mymy49/GM100/Schematics/ES.1/GM100.kicad_pcb

## KiCad design Schematics/ES.1/GM100.kicad_pcb (2026-05-09)

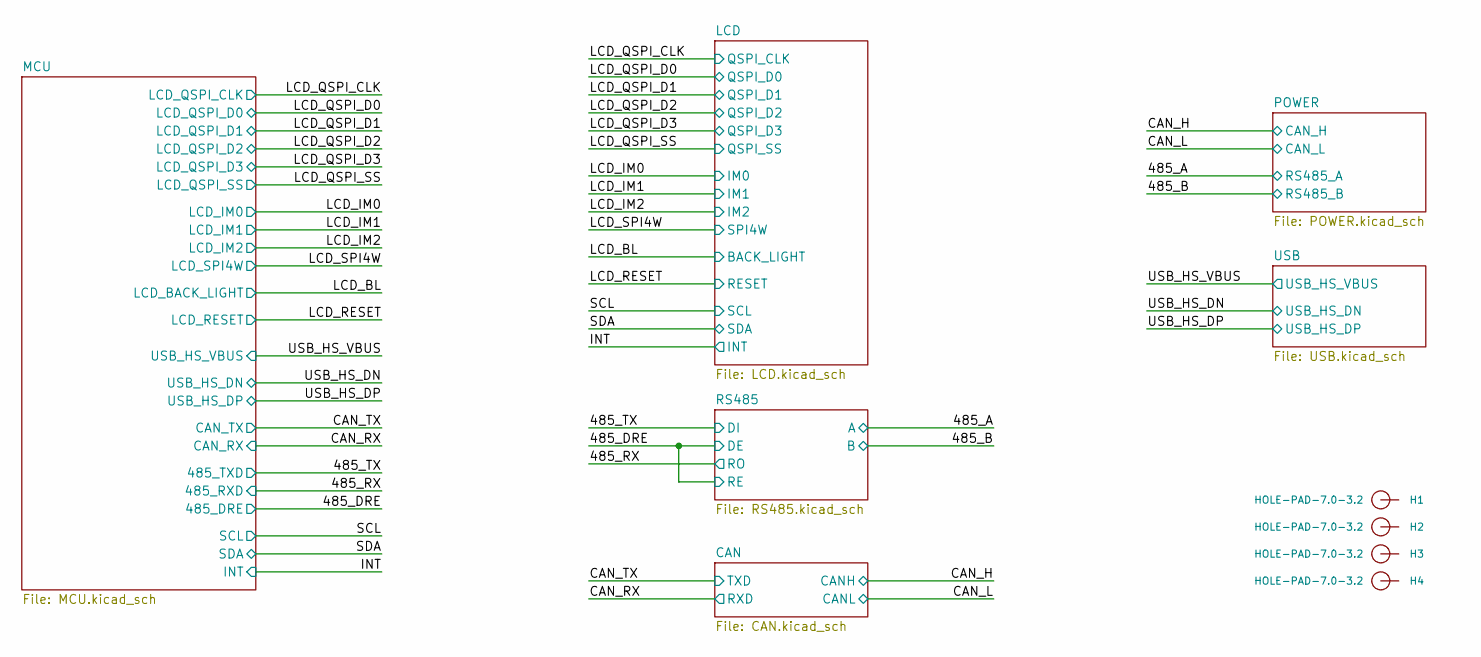
[picture p1: schematic GM100.kicad_sch]

Parts:
H1, H2, H3, H4: HOLE-PAD-7.0-3.2; Hole_7_0_3_2

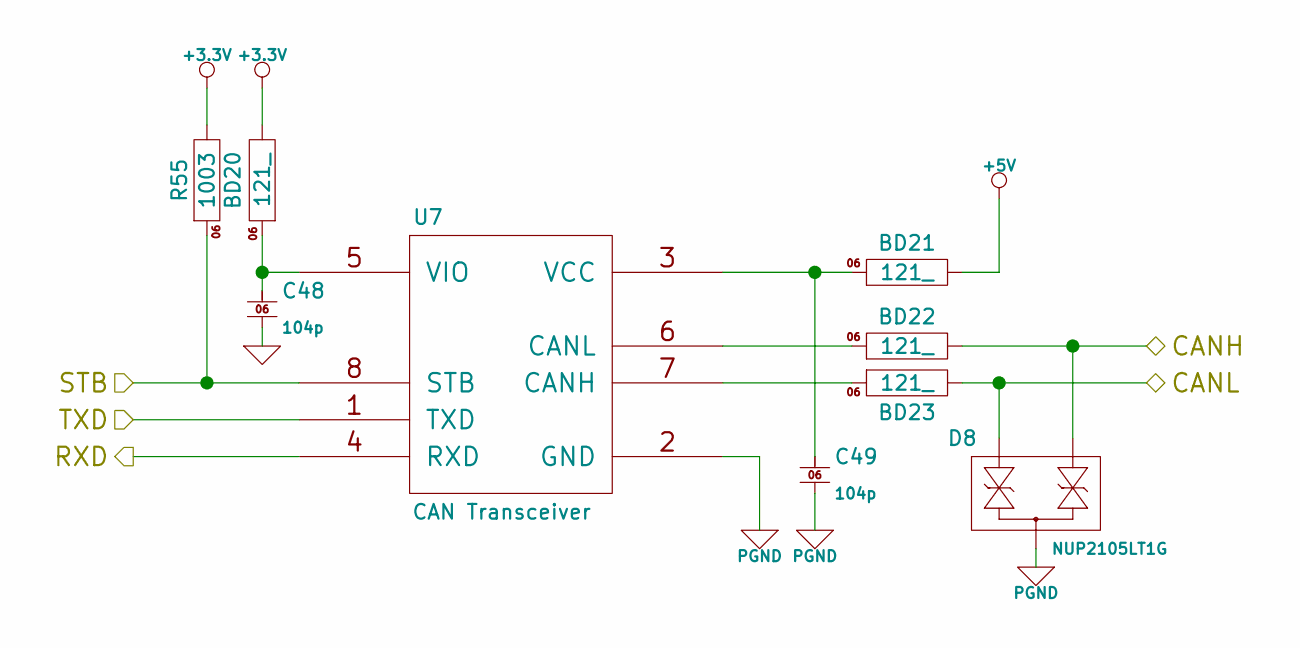
[picture p2: schematic CAN.kicad_sch]

Parts:
BD20, BD21, BD22, BD23: BLM18KG121TN1D; 0603; LCSC Part # C85831
C48, C49: 0603B104K500; 0603; LCSC Part # C314282
D8: NUP2105LT1G; SOT23; LCSC Part # C14486
R55: WR06X1003FTL; 0603; LCSC Part # C132374
U7: CA-IF1042LVS-Q1; SOIC-8; LCSC Part # C20598902

Connections:
+3.3V: BD20.2, R55.2; also elsewhere on the board
+5V: BD21.2; also elsewhere on the board
/CAN/STB: R55.1, U7.8 (STB)
/CAN_H: BD22.2, D8.2 (C1); also elsewhere on the board
/CAN_L: BD23.2, D8.1 (A2); also elsewhere on the board
/CAN_RX: U7.4 (RXD); also elsewhere on the board
/CAN_TX: U7.1 (TXD); also elsewhere on the board
GND: C48.1; also elsewhere on the board
unnamed: BD23.1, U7.7 (CANH)
unnamed: BD22.1, U7.6 (CANL)
unnamed: BD21.1, C49.2, U7.3 (VCC)
unnamed: BD20.1, C48.2, U7.5 (VIO)
PGND: C49.1, D8.3 (A1C2), U7.2 (GND); also elsewhere on the board

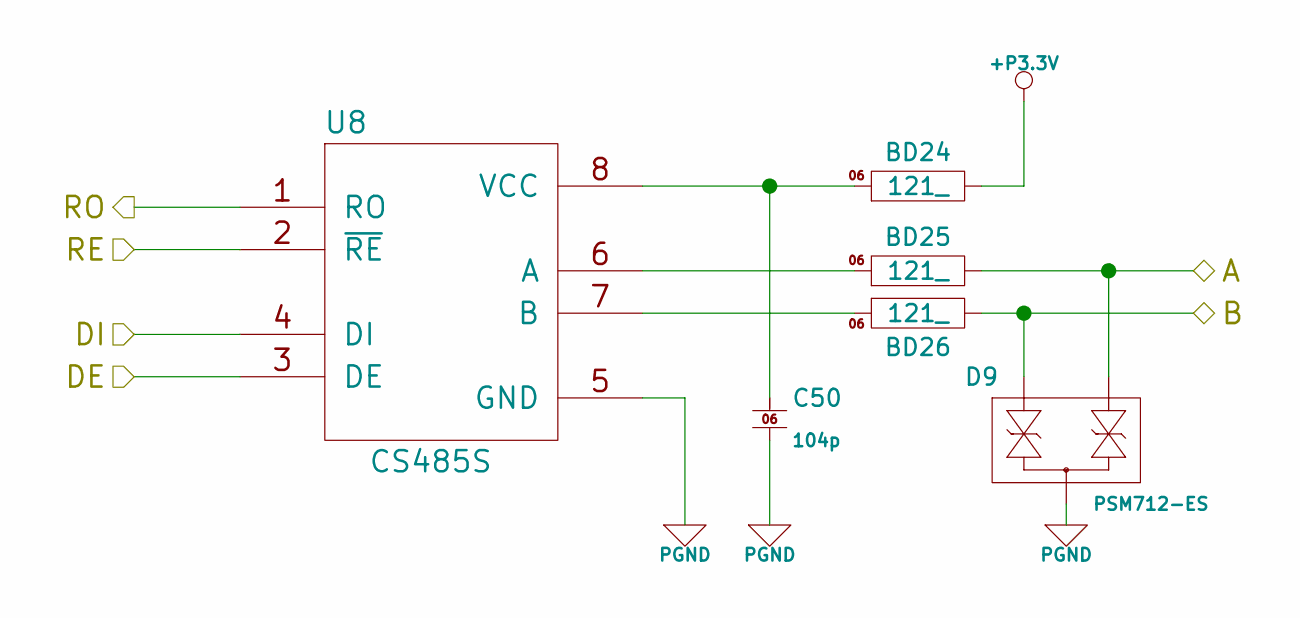
[picture p3: schematic RS485.kicad_sch]

Parts:
BD24, BD25, BD26: BLM18KG121TN1D; 0603; LCSC Part # C85831
C50: 0603B104K500; 0603; LCSC Part # C314282
D9: PSM712-ES; SOT23; LCSC Part # C5180294
U8: CS485S; SOIC-8; LCSC Part # C7422593

Connections:
+P3.3V: BD24.2; also elsewhere on the board
/485_A: BD25.2, D9.2 (C1); also elsewhere on the board
/485_B: BD26.2, D9.1 (A2); also elsewhere on the board
/485_DRE: U8.2 (~RE), U8.3 (DE); also elsewhere on the board
/485_RX: U8.1 (RO); also elsewhere on the board
/485_TX: U8.4 (DI); also elsewhere on the board
unnamed: BD25.1, U8.6 (A)
unnamed: BD26.1, U8.7 (B)
unnamed: BD24.1, C50.2, U8.8 (VCC)
PGND: C50.1, D9.3 (A1C2), U8.5 (GND); also elsewhere on the board

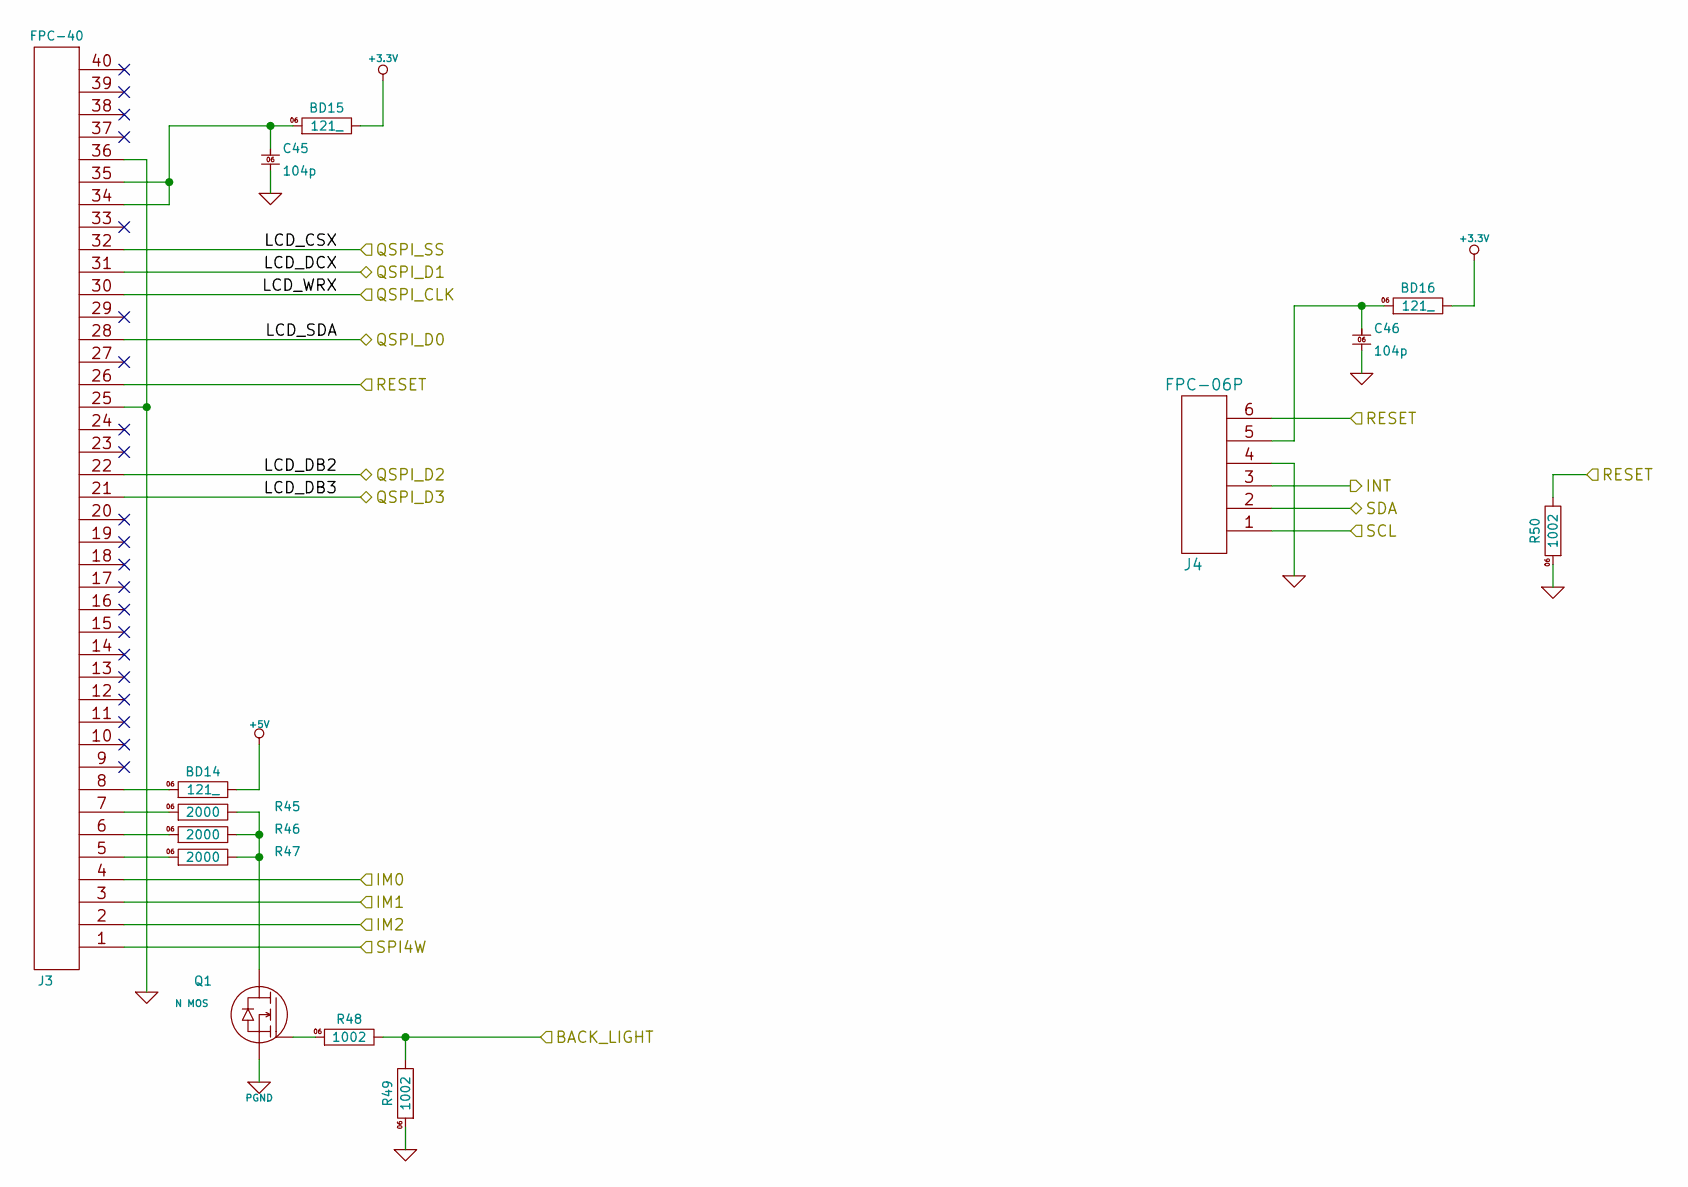
[picture p4: schematic LCD.kicad_sch]

Parts:
BD14, BD15, BD16: BLM18KG121TN1D; 0603; LCSC Part # C85831
C45, C46: 0603B104K500; 0603; LCSC Part # C314282
J3: AFC24-S40FIA-00; JUSHUO_AFC24-S40FIA-00; LCSC Part # C262686
J4: AFC24-S06FIA-00; JUSHUO_AFC24-S06FIA-00; LCSC Part # C262679
Q1: 2N7002K-7; SOT23; LCSC Part # C85047
R45, R46, R47: WR06X2000FTL; 0603; LCSC Part # C163878
R48, R49, R50: WR06X1002FTL; 0603; LCSC Part # C108449

Connections:
+3.3V: BD15.2, BD16.2; also elsewhere on the board
+5V: BD14.2; also elsewhere on the board
/INT: J4.3; also elsewhere on the board
/LCD_BL: R48.2, R49.2; also elsewhere on the board
/LCD_IM0: J3.4; also elsewhere on the board
/LCD_IM1: J3.3; also elsewhere on the board
/LCD_IM2: J3.2; also elsewhere on the board
/LCD_QSPI_CLK: J3.30; also elsewhere on the board
/LCD_QSPI_D0: J3.28; also elsewhere on the board
/LCD_QSPI_D1: J3.31; also elsewhere on the board
/LCD_QSPI_D2: J3.22; also elsewhere on the board
/LCD_QSPI_D3: J3.21; also elsewhere on the board
/LCD_QSPI_SS: J3.32; also elsewhere on the board
/LCD_RESET: J3.26, J4.6, R50.2; also elsewhere on the board
/LCD_SPI4W: J3.1; also elsewhere on the board
/SCL: J4.1; also elsewhere on the board
/SDA: J4.2; also elsewhere on the board
GND: C45.1, C46.1, J3.25, J3.36, J4.4, R49.1, R50.1; also elsewhere on the board
unnamed: BD14.1, J3.8
unnamed: BD15.1, C45.2, J3.34, J3.35
unnamed: BD16.1, C46.2, J4.5
unnamed: J3.5, R47.1
unnamed: J3.6, R46.1
unnamed: J3.7, R45.1
unnamed: Q1.3 (D), R45.2, R46.2, R47.2
unnamed: Q1.1 (G), R48.1
PGND: Q1.2 (S); also elsewhere on the board

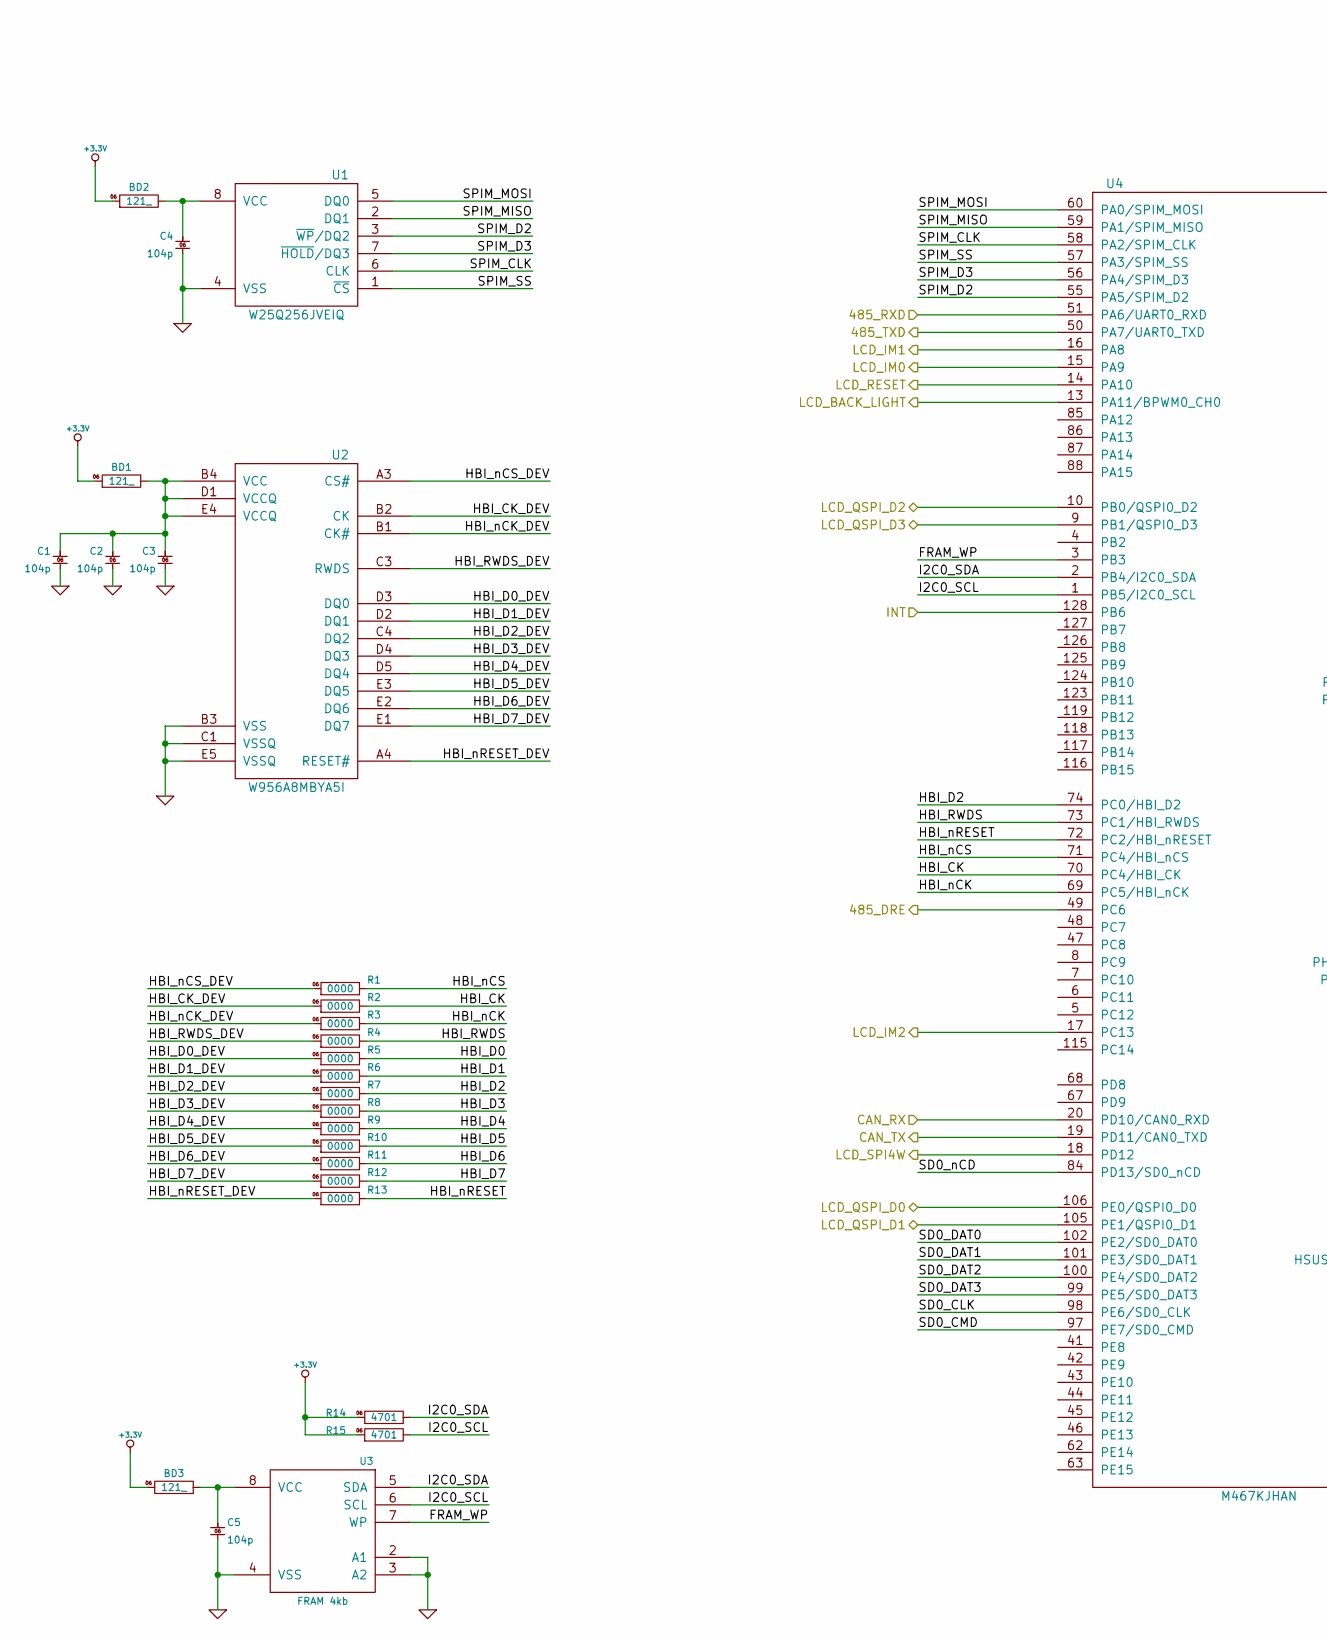
[picture p5: schematic MCU.kicad_sch, part in row 1, column 1]

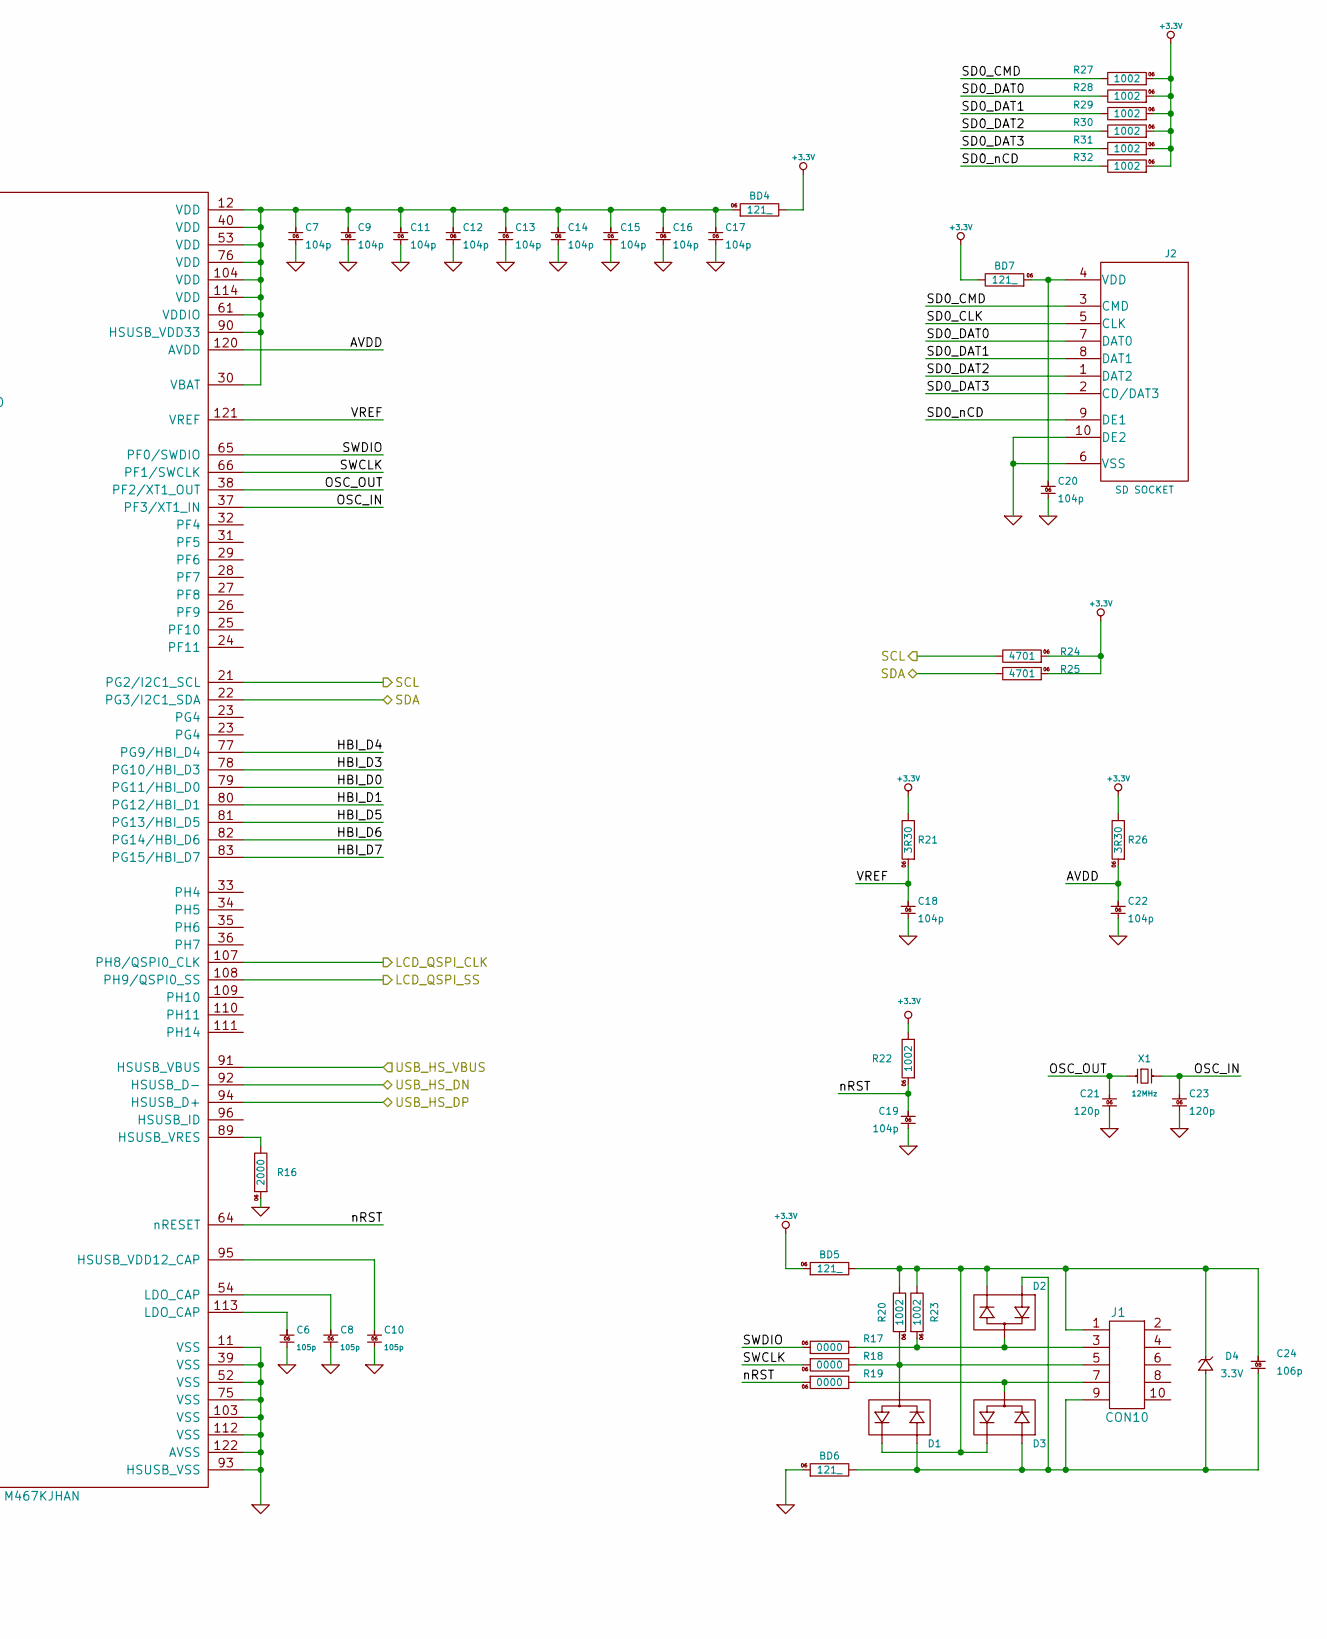
[picture p6: schematic MCU.kicad_sch, part in row 1, column 2]

Parts:
BD1, BD2, BD3, BD4, BD5, BD6, BD7: BLM18KG121TN1D; 0603; LCSC Part # C85831
C1, C2, C3, C4, C5, C7, C9, C11, C12, C13, C14, C15, C16, C17, C18, C19, C20, C22: 0603B104K500; 0603; LCSC Part # C314282
C6, C8, C10: 0603B105K250; 0603; LCSC Part # C388002
C21, C23: 0603N120J500; 0603; LCSC Part # C123529
C24: 0805X106K100; 0805; LCSC Part # C105505
D1, D2, D3: KDS226; SOT23; LCSC Part # C73208
D4: ESD5Z3.3T1G-MS; SOD523; LCSC Part # C3008119
J1: HC-JN254-2-05-W; HCTL_HC-JN254-2-05-W; LCSC Part # C5372873
J2: SD-01A; LCSC Part # C693845
R1, R2, R3, R4, R5, R6, R7, R8, R9, R10, R11, R12, R13, R17, R18, R19: WR06X0000JTL; 0603; LCSC Part # C163836
R14, R15, R24, R25: WR06X4701FTL; 0603; LCSC Part # C163914
R16: WR06X2000FTL; 0603; LCSC Part # C163878
R20, R22, R23, R27, R28, R29, R30, R31, R32: WR06X1002FTL; 0603; LCSC Part # C108449
R21, R26: WR06W3R30FTL; 0603; LCSC Part # C168319
U1: W25Q256JVEIQ; 8-WSON_8x6; LCSC Part # C97522
U2: W956A8MBYA5I; TFBGA24_6x8mm_P1.00mm; LCSC Part # C5375118
U3: FM24CL04B-G; SOIC-8; LCSC Part # C914924
U4: M467KJHAN; LQFP-128_14x14mm_P0.4mm
X1: CF4012M00020; CRSTAL_SMD_3225-4Pin; LCSC Part # C5916243

Connections:
+3.3V: BD1.1, BD2.1, BD3.1, BD4.2, BD5.1, BD7.2, R14.1, R15.1, R21.2, R22.2, R24.1, R25.1, R26.2, R27.1, R28.1, R29.1, R30.1, R31.1, R32.1; also elsewhere on the board
/485_DRE: U4.49 (PC6); also elsewhere on the board
/485_RX: U4.51 (PA6/UART0_RXD); also elsewhere on the board
/485_TX: U4.50 (PA7/UART0_TXD); also elsewhere on the board
/CAN_RX: U4.20 (PD10/CAN0_RXD); also elsewhere on the board
/CAN_TX: U4.19 (PD11/CAN0_TXD); also elsewhere on the board
/INT: U4.128 (PB6); also elsewhere on the board
/LCD_BL: U4.13 (PA11/BPWM0_CH0); also elsewhere on the board
/LCD_IM0: U4.15 (PA9); also elsewhere on the board
/LCD_IM1: U4.16 (PA8); also elsewhere on the board
/LCD_IM2: U4.17 (PC13); also elsewhere on the board
/LCD_QSPI_CLK: U4.107 (PH8/QSPI0_CLK); also elsewhere on the board
/LCD_QSPI_D0: U4.106 (PE0/QSPI0_D0); also elsewhere on the board
/LCD_QSPI_D1: U4.105 (PE1/QSPI0_D1); also elsewhere on the board
/LCD_QSPI_D2: U4.10 (PB0/QSPI0_D2); also elsewhere on the board
/LCD_QSPI_D3: U4.9 (PB1/QSPI0_D3); also elsewhere on the board
/LCD_QSPI_SS: U4.108 (PH9/QSPI0_SS); also elsewhere on the board
/LCD_RESET: U4.14 (PA10); also elsewhere on the board
/LCD_SPI4W: U4.18 (PD12); also elsewhere on the board
/MCU/AVDD: C22.2, R26.1, U4.120 (AVDD)
/MCU/FRAM_WP: U3.7 (WP), U4.3 (PB3)
/MCU/HBI_CK: R2.2, U4.70 (PC4/HBI_CK)
/MCU/HBI_CK_DEV: R2.1, U2.B2 (CK)
/MCU/HBI_D0: R5.2, U4.79 (PG11/HBI_D0)
/MCU/HBI_D0_DEV: R5.1, U2.D3 (DQ0)
/MCU/HBI_D1: R6.2, U4.80 (PG12/HBI_D1)
/MCU/HBI_D1_DEV: R6.1, U2.D2 (DQ1)
/MCU/HBI_D2: R7.2, U4.74 (PC0/HBI_D2)
/MCU/HBI_D2_DEV: R7.1, U2.C4 (DQ2)
/MCU/HBI_D3: R8.2, U4.78 (PG10/HBI_D3)
/MCU/HBI_D3_DEV: R8.1, U2.D4 (DQ3)
/MCU/HBI_D4: R9.2, U4.77 (PG9/HBI_D4)
/MCU/HBI_D4_DEV: R9.1, U2.D5 (DQ4)
/MCU/HBI_D5: R10.2, U4.81 (PG13/HBI_D5)
/MCU/HBI_D5_DEV: R10.1, U2.E3 (DQ5)
/MCU/HBI_D6: R11.2, U4.82 (PG14/HBI_D6)
/MCU/HBI_D6_DEV: R11.1, U2.E2 (DQ6)
/MCU/HBI_D7: R12.2, U4.83 (PG15/HBI_D7)
/MCU/HBI_D7_DEV: R12.1, U2.E1 (DQ7)
/MCU/HBI_RWDS: R4.2, U4.73 (PC1/HBI_RWDS)
/MCU/HBI_RWDS_DEV: R4.1, U2.C3 (RWDS)
/MCU/HBI_nCK: R3.2, U4.69 (PC5/HBI_nCK)
/MCU/HBI_nCK_DEV: R3.1, U2.B1 (CK#)
/MCU/HBI_nCS: R1.2, U4.71 (PC4/HBI_nCS)
/MCU/HBI_nCS_DEV: R1.1, U2.A3 (CS#)
/MCU/HBI_nRESET: R13.2, U4.72 (PC2/HBI_nRESET)
/MCU/HBI_nRESET_DEV: R13.1, U2.A4 (RESET#)
/MCU/I2C0_SCL: R15.2, U3.6 (SCL), U4.1 (PB5/I2C0_SCL)
/MCU/I2C0_SDA: R14.2, U3.5 (SDA), U4.2 (PB4/I2C0_SDA)
/MCU/OSC_IN: C23.2, U4.37 (PF3/XT1_IN), X1.3
/MCU/OSC_OUT: C21.2, U4.38 (PF2/XT1_OUT), X1.1
/MCU/SD0_CLK: J2.5 (CLK), U4.98 (PE6/SD0_CLK)
/MCU/SD0_CMD: J2.3 (CMD), R27.2, U4.97 (PE7/SD0_CMD)
/MCU/SD0_DAT0: J2.7 (DAT0), R28.2, U4.102 (PE2/SD0_DAT0)
/MCU/SD0_DAT1: J2.8 (DAT1), R29.2, U4.101 (PE3/SD0_DAT1)
/MCU/SD0_DAT2: J2.1 (DAT2), R30.2, U4.100 (PE4/SD0_DAT2)
/MCU/SD0_DAT3: J2.2 (CD/DAT3), R31.2, U4.99 (PE5/SD0_DAT3)
/MCU/SD0_nCD: J2.9 (DE1), R32.2, U4.84 (PD13/SD0_nCD)
/MCU/SPIM_CLK: U1.6 (CLK), U4.58 (PA2/SPIM_CLK)
/MCU/SPIM_D2: U1.3 (~WP/DQ2), U4.55 (PA5/SPIM_D2)
/MCU/SPIM_D3: U1.7 (~HOLD/DQ3), U4.56 (PA4/SPIM_D3)
/MCU/SPIM_MISO: U1.2 (DQ1), U4.59 (PA1/SPIM_MISO)
/MCU/SPIM_MOSI: U1.5 (DQ0), U4.60 (PA0/SPIM_MOSI)
/MCU/SPIM_SS: U1.1 (~CS), U4.57 (PA3/SPIM_SS)
/MCU/SWCLK: R18.1, U4.66 (PF1/SWCLK)
/MCU/SWDIO: R17.1, U4.65 (PF0/SWDIO)
/MCU/VREF: C18.2, R21.1, U4.121 (VREF)
/MCU/nRST: C19.2, R19.1, R22.1, U4.64 (nRESET)
/SCL: R24.2, U4.21 (PG2/I2C1_SCL); also elsewhere on the board
/SDA: R25.2, U4.22 (PG3/I2C1_SDA); also elsewhere on the board
/USB_HS_DN: U4.92 (HSUSB_D-); also elsewhere on the board
/USB_HS_DP: U4.94 (HSUSB_D+); also elsewhere on the board
/USB_HS_VBUS: U4.91 (HSUSB_VBUS); also elsewhere on the board
GND: BD6.1, C1.1, C2.1, C3.1, C4.1, C5.1, C6.1, C7.1, C8.1, C9.1, C10.1, C11.1, C12.1, C13.1, C14.1, C15.1, C16.1, C17.1, C18.1, C19.1, C20.1, C21.1, C22.1, C23.1, J2.6 (VSS), J2.10 (DE2), R16.1, U1.4 (VSS), U2.B3 (VSS), U2.C1 (VSSQ), U2.E5 (VSSQ), U3.2 (A1), U3.3 (A2), U3.4 (VSS), U4.11 (VSS), U4.39 (VSS), U4.52 (VSS), U4.75 (VSS), U4.93 (HSUSB_VSS), U4.103 (VSS), U4.112 (VSS), U4.122 (AVSS); also elsewhere on the board
unnamed: C6.2, U4.113 (LDO_CAP)
unnamed: C8.2, U4.54 (LDO_CAP)
unnamed: D1.3 (A1C2), J1.5, R18.2, R20.1
unnamed: BD6.2, C24.1, D1.1 (A2), D2.1 (A2), D3.1 (A2), D4.1 (A), J1.9
unnamed: BD5.2, C24.2, D1.2 (C1), D2.2 (C1), D3.2 (C1), D4.2 (K), J1.1, R20.2, R23.2
unnamed: D2.3 (A1C2), J1.3, R17.2, R23.1
unnamed: D3.3 (A1C2), J1.7, R19.2
unnamed: BD7.1, C20.2, J2.4 (VDD)
unnamed: BD2.2, C4.2, U1.8 (VCC)
unnamed: BD1.2, C1.2, C2.2, C3.2, U2.B4 (VCC), U2.D1 (VCCQ), U2.E4 (VCCQ)
unnamed: BD3.2, C5.2, U3.8 (VCC)
unnamed: C10.2, U4.95 (HSUSB_VDD12_CAP)
unnamed: BD4.1, C7.2, C9.2, C11.2, C12.2, C13.2, C14.2, C15.2, C16.2, C17.2, U4.12 (VDD), U4.30 (VBAT), U4.40 (VDD), U4.53 (VDD), U4.61 (VDDIO), U4.76 (VDD), U4.90 (HSUSB_VDD33), U4.104 (VDD), U4.114 (VDD)
unnamed: R16.2, U4.89 (HSUSB_VRES)

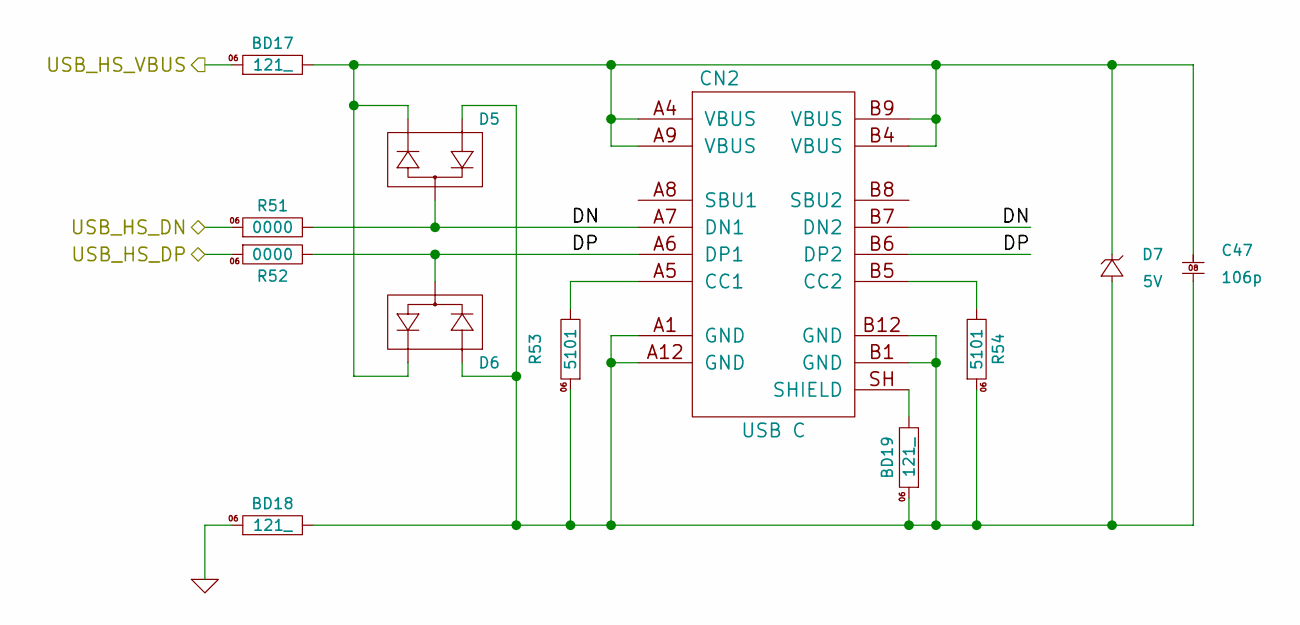
[picture p7: schematic USB.kicad_sch]

Parts:
BD17, BD18, BD19: BLM18KG121TN1D; 0603; LCSC Part # C85831
C47: 0805X106K100; 0805; LCSC Part # C105505
CN2: GT-USB-7010ASV; LCSC Part # C2988369
D5, D6: KDS226; SOT23; LCSC Part # C73208
D7: SJD12A05L01; SOD123; LCSC Part # C5563731
R51, R52: WR06X0000JTL; 0603; LCSC Part # C163836
R53, R54: WR06X5101FTL; 0603; LCSC Part # C113390

Connections:
/USB/DN: CN2.A7 (DN1), CN2.B7 (DN2), D5.3 (A1C2), R51.2
/USB/DP: CN2.A6 (DP1), CN2.B6 (DP2), D6.3 (A1C2), R52.2
/USB_HS_DN: R51.1; also elsewhere on the board
/USB_HS_DP: R52.1; also elsewhere on the board
/USB_HS_VBUS: BD17.1; also elsewhere on the board
GND: BD18.1; also elsewhere on the board
unnamed: CN2.A5 (CC1), R53.2
unnamed: CN2.B5 (CC2), R54.2
unnamed: BD19.2, CN2.SH (SHIELD)
unnamed: BD18.2, BD19.1, C47.1, CN2.A1 (GND), CN2.A12 (GND), CN2.B1 (GND), CN2.B12 (GND), D5.1 (A2), D6.1 (A2), D7.1 (A), R53.1, R54.1
unnamed: BD17.2, C47.2, CN2.A4 (VBUS), CN2.A9 (VBUS), CN2.B4 (VBUS), CN2.B9 (VBUS), D5.2 (C1), D6.2 (C1), D7.2 (K)

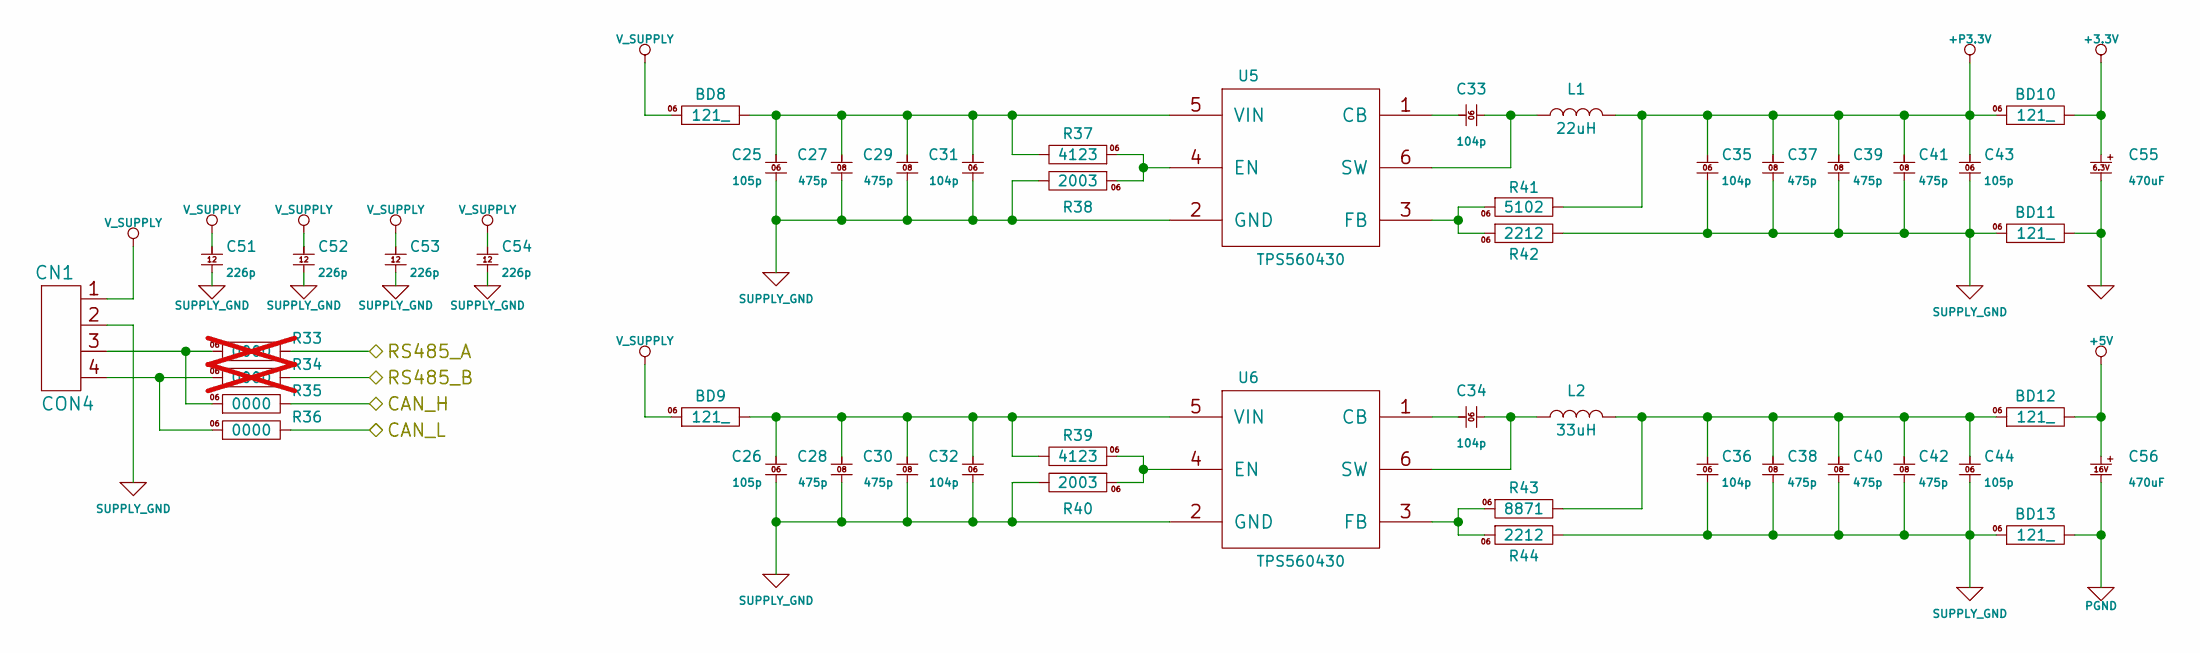
[picture p8: schematic POWER.kicad_sch]

Parts:
BD8, BD9, BD10, BD11, BD12, BD13: BLM18KG121TN1D; 0603; LCSC Part # C85831
C25, C26, C43, C44: 0603B105K250; 0603; LCSC Part # C388002
C27, C28, C29, C30, C37, C38, C39, C40, C41, C42: 0805B475K160; 0805; LCSC Part # C123624
C31, C32, C33, C34, C35, C36: 0603B104K500; 0603; LCSC Part # C314282
C51, C52, C53, C54: 1206B226K100; 1206; LCSC Part # C237195
C55: RVT0J471M0607; CP_Elec_6.3x7.7; LCSC Part # C3354
C56: VEJ471M1CTR-0810; CP_Elec_8x10; LCSC Part # C176671
CN1: WJ2EDGRC-5.08-4P; KANGNEX_WJ2EDGRC-5.08-4P; LCSC Part # C8446
L1: XRNR4030-22uH/M; XR_XRNR4030; LCSC Part # C5289362
L2: XRNR4030-33uH/M; XR_XRNR4030; LCSC Part # C5289365
R33, R34: WR06X0000JTL; 0603; LCSC Part # C163836; not fitted
R35, R36: WR06X0000JTL; 0603; LCSC Part # C163836
R37, R39: WR06X4123FTL; 0603; LCSC Part # C170594
R38, R40: WR06X2003FTL; 0603; LCSC Part # C163877
R41: WR06X5102FTL; 0603; LCSC Part # C163933
R42, R44: WR06X2212FTL; 0603; LCSC Part # C168292
R43: WR06X8871FTL; 0603; LCSC Part # C170687
U5, U6: TPS560430XDBV; DBV0006A; LCSC Part # C524782

Connections:
+3.3V: BD10.2, C55.1; also elsewhere on the board
+5V: BD12.2, C56.1; also elsewhere on the board
+P3.3V: BD10.1, C35.2, C37.2, C39.2, C41.2, C43.2, L1.2, R41.2; also elsewhere on the board
/485_A: R33.2; also elsewhere on the board
/485_B: R34.2; also elsewhere on the board
/CAN_H: R35.2; also elsewhere on the board
/CAN_L: R36.2; also elsewhere on the board
GND: BD11.2, C55.2; also elsewhere on the board
unnamed: BD12.1, C36.2, C38.2, C40.2, C42.2, C44.2, L2.2, R43.2
unnamed: CN1.3, R33.1, R35.1
unnamed: CN1.4, R34.1, R36.1
unnamed: C33.2, U5.1 (CB)
unnamed: R37.1, R38.1, U5.4 (EN)
unnamed: R41.1, R42.1, U5.3 (FB)
unnamed: C33.1, L1.1, U5.6 (SW)
unnamed: BD8.2, C25.2, C27.2, C29.2, C31.2, R37.2, U5.5 (VIN)
unnamed: C34.2, U6.1 (CB)
unnamed: R39.1, R40.1, U6.4 (EN)
unnamed: R43.1, R44.1, U6.3 (FB)
unnamed: C34.1, L2.1, U6.6 (SW)
unnamed: BD9.2, C26.2, C28.2, C30.2, C32.2, R39.2, U6.5 (VIN)
PGND: BD13.2, C56.2; also elsewhere on the board
SUPPLY_GND: BD11.1, BD13.1, C25.1, C26.1, C27.1, C28.1, C29.1, C30.1, C31.1, C32.1, C35.1, C36.1, C37.1, C38.1, C39.1, C40.1, C41.1, C42.1, C43.1, C44.1, C51.1, C52.1, C53.1, C54.1, CN1.2, R38.2, R40.2, R42.2, R44.2, U5.2 (GND), U6.2 (GND)
V_SUPPLY: BD8.1, BD9.1, C51.2, C52.2, C53.2, C54.2, CN1.1

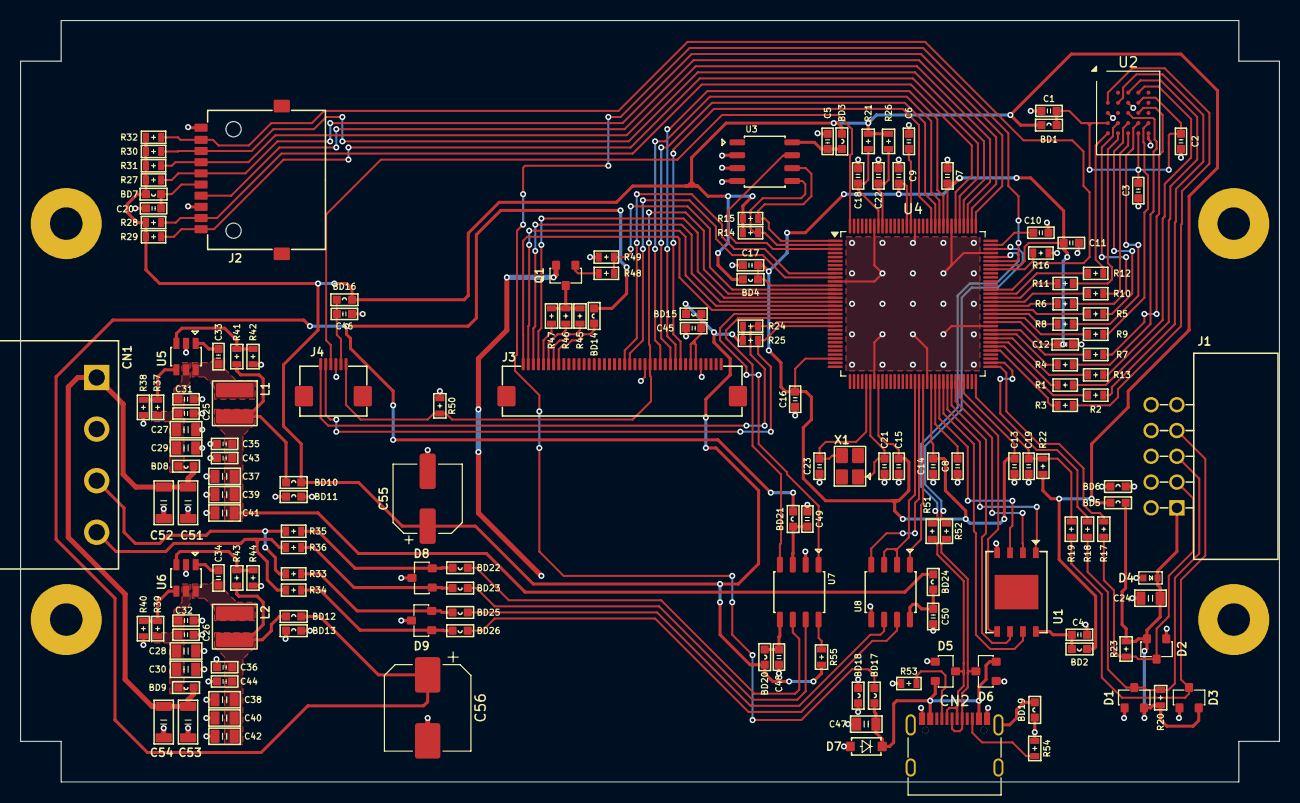
[picture p9: board GM100.kicad_pcb from above]

Board: 2 copper layers, 124.0 x 75.0 mm, 168 parts (0 on the bottom side), 133 nets.
