mymy49/GM100/SourceCodes/ES.1/BSP/app/src/bsp.cpp

/*
 * Copyright (c) 2024 Yoon-Ki Hong
 *
 * This file is subject to the terms and conditions of the MIT License.
 * See the file "LICENSE" in the main directory of this archive for more details.
 */

#include <bsp.h>
#include <yss/instance.h>

FM24CL04B fram;

P4309N_DCT lcd;

GT911 touch;

FrameBufferRgb565LE fb;

void initializeBoard(void)
{
	// I2C0 initialization
	I2c::mainConfig_t i2c0Config =
	{
		I2c::SPEED_STANDARD //speed_t speed;
	};
	
	gpioB.setAsAltFunc(4, Gpio::PB4_I2C0_SDA, Gpio::AF_OPEN_DRAIN);
	gpioB.setAsAltFunc(5, Gpio::PB5_I2C0_SCL, Gpio::AF_OPEN_DRAIN);
	
	i2c0.enableClock();
	i2c0.initialize(i2c0Config);
	i2c0.enableInterrupt();

	// I2C1 initialization
	I2c::mainConfig_t i2c1Config =
	{
		I2c::SPEED_STANDARD //speed_t speed;
	};
	
	gpioG.setAsAltFunc(2, Gpio::PG2_I2C1_SCL, Gpio::AF_OPEN_DRAIN);
	gpioG.setAsAltFunc(3, Gpio::PG3_I2C1_SDA, Gpio::AF_OPEN_DRAIN);
	
	i2c1.enableClock();
	i2c1.initialize(i2c1Config);
	i2c1.enableInterrupt();

	// UART0 initialization
	Uart::config_t uart0Config = 
	{
		Uart::MODE_NORMAL,	//mode_t mode;
		115200,				//uint32_t baudrate;
		Uart::STOP_1BIT,	//stopbit_t stopbit;
		Uart::PARITY_NONE,	//parityBit_t parity;
		nullptr,			//void *rcvBuf;
		128					//uint32_t rcvBufSize;
	};

	gpioA.setAsAltFunc(6, Gpio::PA6_UART0_RXD);
	gpioA.setAsAltFunc(7, Gpio::PA7_UART0_TXD);

	uart0.enableClock();
	uart0.initialize(uart0Config);
	uart0.enableInterrupt();

	// BPWM0 (TFT-LCD Back Light) initialization
	//gpioA.setAsAltFunc(11, Gpio::PA11_BPWM0_CH0);	// Set PA11 to BPWM0 CH0

	//bpwm0.enableClock();			// Enable BPWM0 clock
	//bpwm0.initialize(1000);		// Initialize the output period of BPWM0 to 1kHz.
	//bpwm0.setAsPwmOutput(0);		// Set CH0 of BPWM0 as PWM inverted output
	//bpwm0.start();				// Start timer counter

	//bpwm0.setDutyRatio(0, 1.0);	// Set the output duty cycle of BPWM0 CH0 to 10%.

	// Temporarily disable the PWM function due to a problem where the PWM output stopped during debugging, causing the LCD screen to be invisible.
	gpioA.setAsOutput(11);
	gpioA.setOutput(11, true);

	// SDH0 initialization
	gpioE.setAsAltFunc(2, Gpio::PE2_SD0_DAT0);
	gpioE.setAsAltFunc(3, Gpio::PE3_SD0_DAT1);
	gpioE.setAsAltFunc(4, Gpio::PE4_SD0_DAT2);
	gpioE.setAsAltFunc(5, Gpio::PE5_SD0_DAT3);
	gpioE.setAsAltFunc(6, Gpio::PE6_SD0_CLK);
	gpioE.setAsAltFunc(7, Gpio::PE7_SD0_CMD);
	gpioD.setAsAltFunc(13, Gpio::PD13_SD0_nCD);

	sdh0.enableClock();
	sdh0.initialize();
	sdh0.enableInterrupt();
	sdh0.setDetectPin({&gpioD, 13});

	// QSPI0 initialization
	gpioE.setAsAltFunc(0, Gpio::PE0_QSPI0_MOSI0, Gpio::AF_PUSH_PULL, Gpio::SLEWRATE_HIGH);
	gpioE.setAsAltFunc(1, Gpio::PE1_QSPI0_MISO0, Gpio::AF_PUSH_PULL, Gpio::SLEWRATE_HIGH);
	gpioB.setAsAltFunc(0, Gpio::PB0_QSPI0_MOSI1, Gpio::AF_PUSH_PULL, Gpio::SLEWRATE_HIGH); 
	gpioB.setAsAltFunc(1, Gpio::PB1_QSPI0_MISO1, Gpio::AF_PUSH_PULL, Gpio::SLEWRATE_HIGH);
	gpioH.setAsAltFunc(8, Gpio::PH8_QSPI0_CLK, Gpio::AF_PUSH_PULL, Gpio::SLEWRATE_HIGH);

	Quadspi::config_t qspi0Config = 
	{
		Quadspi::MODE_MAIN	//mode_t mode;
	};

	qspi0.enableClock();
	qspi0.initialize(qspi0Config);
	qspi0.enableInterrupt();

	// CANFD0 initialization
	gpioD.setAsAltFunc(10, Gpio::PD10_CAN0_RXD);
	gpioD.setAsAltFunc(11, Gpio::PD11_CAN0_TXD);

	NuvotonCanFd::config_t canfd0Config = 
	{
		9,				//uint8_t dbrp;				// 0 ~ 31
		14,				//uint8_t dtseg1;			// 0 ~ 31
		1,				//uint8_t dtseg2;			// 0 ~ 15
		1,				//uint8_t dsjw;				// 0 ~ 15
		44,				//uint16_t nbrp;			// 0 ~ 511
		12,				//uint8_t ntseg1;			// 1 ~ 255
		1,				//uint8_t ntseg2;			// 1 ~ 127
		1,				//uint8_t nsjw;				// 0 ~ 127
		true,			//bool fdOperaiton;			// CAN FD 모드 활성화
		false,			//bool enableSilent;		// Silent 모드 활성화
		true			//bool enableLoopback;		// Loopback 모드 활성화
	};

	canfd0.enableClock();
	canfd0.initialize(canfd0Config);
	canfd0.enableInterrupt();

	// FRAM initialization
	FM24CL04B::config_t framConfig = 
	{
		i2c0,			//I2c &peri;
		{&gpioB, 3},	//pin_t writeProtectPin;
		0				//uint8_t addr;
	};

	gpioB.setAsOutput(3);

	fram.initialize(framConfig);

	// Touch Screen initialization
	// Handle the reset pin in the touchscreen initialization function
	// The reset pins of the TFT-LCD and the touchscreen are bundled together.
	gpioA.setAsOutput(10);
	gpioA.setOutput(10, false);	

	GT911::config_t touchConfig = 
	{
		i2c1,			//I2c &peri;
		{&gpioB, 6},	//pin_t isrPin;
		{&gpioA, 10},	//pin_t resetPin;
	};

	touch.initialize(touchConfig);

	// LCD initialization
	P4309N_DCT::config_t lcdConfig = 
	{
		qspi0,		//Spi &peri;
		{0, 0},		//pin_t reset;
		{&gpioH, 9}	//pin_t cs;
	};

	gpioH.setAsOutput(9);	// CS
	gpioA.setAsOutput(9);	// IM0
	gpioA.setAsOutput(8);	// IM1
	gpioC.setAsOutput(13);	// IM2
	gpioD.setAsOutput(12);	// SPI4W

	gpioH.setOutput(9, true);	// CS
	gpioA.setOutput(9, true);	// IM0
	gpioA.setOutput(8, true);	// IM1
	gpioC.setOutput(13, false);	// IM2
	gpioD.setOutput(12, false);	// SPI4W

	fb.malloc(480 * 272);
	fb.setSize(480, 272);
	lcd.setFrameBuffer(fb);
	lcd.initialize(lcdConfig);
	
	lcd.setBackgroundColor({0xFF, 0x00, 0x00});
	lcd.clear();
	thread::delay(250);

	lcd.setBackgroundColor({0x00, 0xFF, 0x00});
	lcd.clear();
	thread::delay(250);

	lcd.setBackgroundColor({0x00, 0x00, 0xFF});
	lcd.clear();
	thread::delay(250);

	lcd.setBackgroundColor({0xFF, 0xFF, 0xFF});
	lcd.clear();
}

void initializeSdram(void)
{
	Gpio::altFuncPackage_t hbiPort[13]
	{
		{PC, 0, Gpio::PC0_HBI_D2},
		{PC, 1, Gpio::PC1_HBI_RWDS},
		{PC, 2, Gpio::PC2_HBI_nRESET},
		{PC, 3, Gpio::PC3_HBI_nCS},
		{PC, 4, Gpio::PC4_HBI_CK},
		{PC, 5, Gpio::PC5_HBI_nCK},
		{PG, 9, Gpio::PG9_HBI_D4},
		{PG, 10, Gpio::PG10_HBI_D3},
		{PG, 11, Gpio::PG11_HBI_D0},
		{PG, 12, Gpio::PG12_HBI_D1},
		{PG, 13, Gpio::PG13_HBI_D5},
		{PG, 14, Gpio::PG14_HBI_D6},
		{PG, 15, Gpio::PG15_HBI_D7}
	};

	gpioA.setPackageAsAltFunc(hbiPort, 13, Gpio::AF_PUSH_PULL, Gpio::SLEWRATE_FAST);
	
	// 
	Hbi::config_t config =
	{
		4,								//float tCSS_min_ns;
		40,								//float tACC_min_ns;
		0,								//float tCSH_min_ns;
		10,								//float tCSHI_min_ns;
		4,								//float tCSM_max_us;
		Hbi::BURST_GROUP_SIZE_32BYTES,	//bustGroupSize_t bgs;5
		8 * 1024 * 1024,				//uint32_t capcacity;
		200 * 1000 * 1000				//uint32_t maxFrequency;
	};

	clock.enableAhb0Clock(CLK_AHBCLK0_HBICKEN_Pos);
	hbi.initialize(config, clock.getHclkClockFrequency());
	nvic.enableInterrupt(HBI_IRQn);
}
