mymy49/GM100/(commit log)

2026-05-09 - Add ES.1 circuit
    [CAN.kicad_sch, GM100.kicad_pcb, GM100.kicad_sch, LCD.kicad_sch, MCU.kicad_sch, POWER.kicad_sch, RS485.kicad_sch, USB.kicad_sch]
2026-05-09 - Fixed an issue with incorrect file paths in peripheral device registers.
